TheEarthmaster/nightlight/hdw/nightlight/nightlight.xlsx

Reference | Quantity | Value | Digi-Key PN
C202 C201 C303 C402 C401 C502 C601 C701 C704 C802 C801 C901 C903 C904 C902 C905 | 16 | 0.1uF | 1276-1000-1-ND
C301 | 1 | 2.2uF | 1276-1085-1-ND
C302 | 1 | 22uF | 490-14661-1-ND
C304 | 1 | 47uF | 490-9961-1-ND
C503 C602 C604 C702 | 4 | 10nF | 311-1085-1-ND
C504 C501 | 2 | 4.7uF | 1276-2789-1-ND
C603 C703 | 2 | 1nF | 311-1080-1-ND
C705 | 1 | 100uF | 478-7997-1-ND
D505 | 1 | MBR0530 | MBR0530CT-ND
D509 D511 D507 D504 D502 D508 D510 D506 D503 D501 | 10 | warm white | 1214-1445-1-ND
D701 | 1 | 24V | SMAJ24CALFCT-ND
D901 D903 D905 | 3 | green | 160-1446-1-ND
D904 D902 | 2 | red | 160-1447-1-ND
H1001 H1002 H1003 H1004 | 4 | MountingHole
J201 | 1 | PICKIT3
J701 | 1 | +12V IN AUX | CP-202BH-ND
J801 | 1 | PIR Sensor | 1528-1991-ND
L301 | 1 | 4.7uH | 541-1222-1-ND
L501 | 1 | 3.3uH | 541-1269-1-ND
Q201 | 1 | 2N7002 | 2N7002NCT-ND
Q601 | 1 | BPW85A | BPW85A-ND
Q701 Q702 | 2 | IPC100N04S51R7ATMA1 | IPC100N04S51R7ATMA1CT-ND
R201 R203 R705 R706 | 4 | 10 | A130079CT-ND
R202 R204 R305 R303 R304 R301 R402 R502 R601 R707 R801 R802 R905 R902 R906 | 15 | 10k | RNCP0603FTD10K0CT-ND
R302 | 1 | 1.2k | RMCF0603FT1K20CT-ND
R401 R602 | 2 | 499 | P499HCT-ND
R501 | 1 | 5.1K | 311-5.10KHRCT-ND
R503 | 1 | 0.18 | RL12S.18FCT-ND
R504 | 1 | 15.8K | 311-15.8KHRCT-ND
R505 | 1 | 1.07k | RMCF0603FT1K07CT-ND
R701 | 1 | 6.04M | 541-6.04MHCT-ND
R702 | 1 | 86.6k | RMC50603FT86K6CT-ND
R703 | 1 | 243k | RMCF0603FT243KCT-ND
R704 | 1 | 100k | RMCF0603FT100KCT-ND
R708 | 1 | 5.1k | 749-16663-1-ND
R901 R904 R907 R903 R908 | 5 | 1k | RNCP0603FTD1K00CT-ND
SW201 | 1 | MRST
SW401 | 1 | Cap_Touch
U201 | 1 | PIC16F1518-ISO | PIC16F1518-I/SOCT-ND
U301 | 1 | LTC3624DD | LTC3624IDD-3.3#PBF
U401 | 1 | AT42QT1010-TSHR | AT42AT1010-TSHRCT-ND
U501 | 1 | LT1618DD | LT1618EDD#PBF-ND
U601 | 1 | OPA340NA | 296-26275-1-ND
U701 | 1 | LTC4365DDB | LTC4365IDDB#TRMPBFCT-ND
U801 | 1 | 74LVC1G17 | 296-11934-1-ND
U901 U903 U904 U902 U905 | 5 | 74LVC1G06_Power | 296-8484-1-ND
