TheEarthmaster/nightlight/(list of files, cad)

Other CAD files:
sfw/u201_firmware/nightlight_firmware.X/dist/default/production/nightlight_firmware.X.production.obj
