TheEarthmaster/nightlight/hdw/nightlight/nightlight.pdf

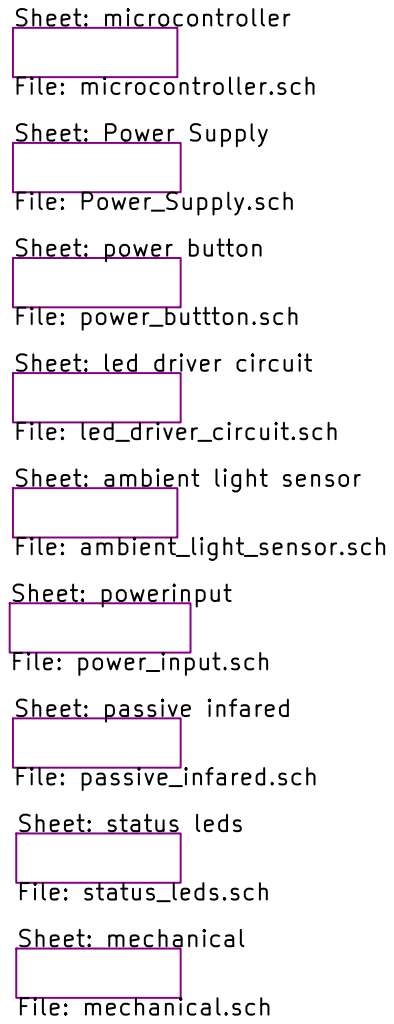
[picture p1: page 1]

Sheet: microcontroller File: microcontroller.sch Sheet: Power Supply

File: power_buttton.sch Sheet: led driver circuit File: led_driver_circuit.sch Sheet: ambient light sensor

File: passive_infared.sch Sheet: status leds File: status_leds.sch Sheet: mechanical File: mechanical.sch

File: nightlight.sch Sheet: /

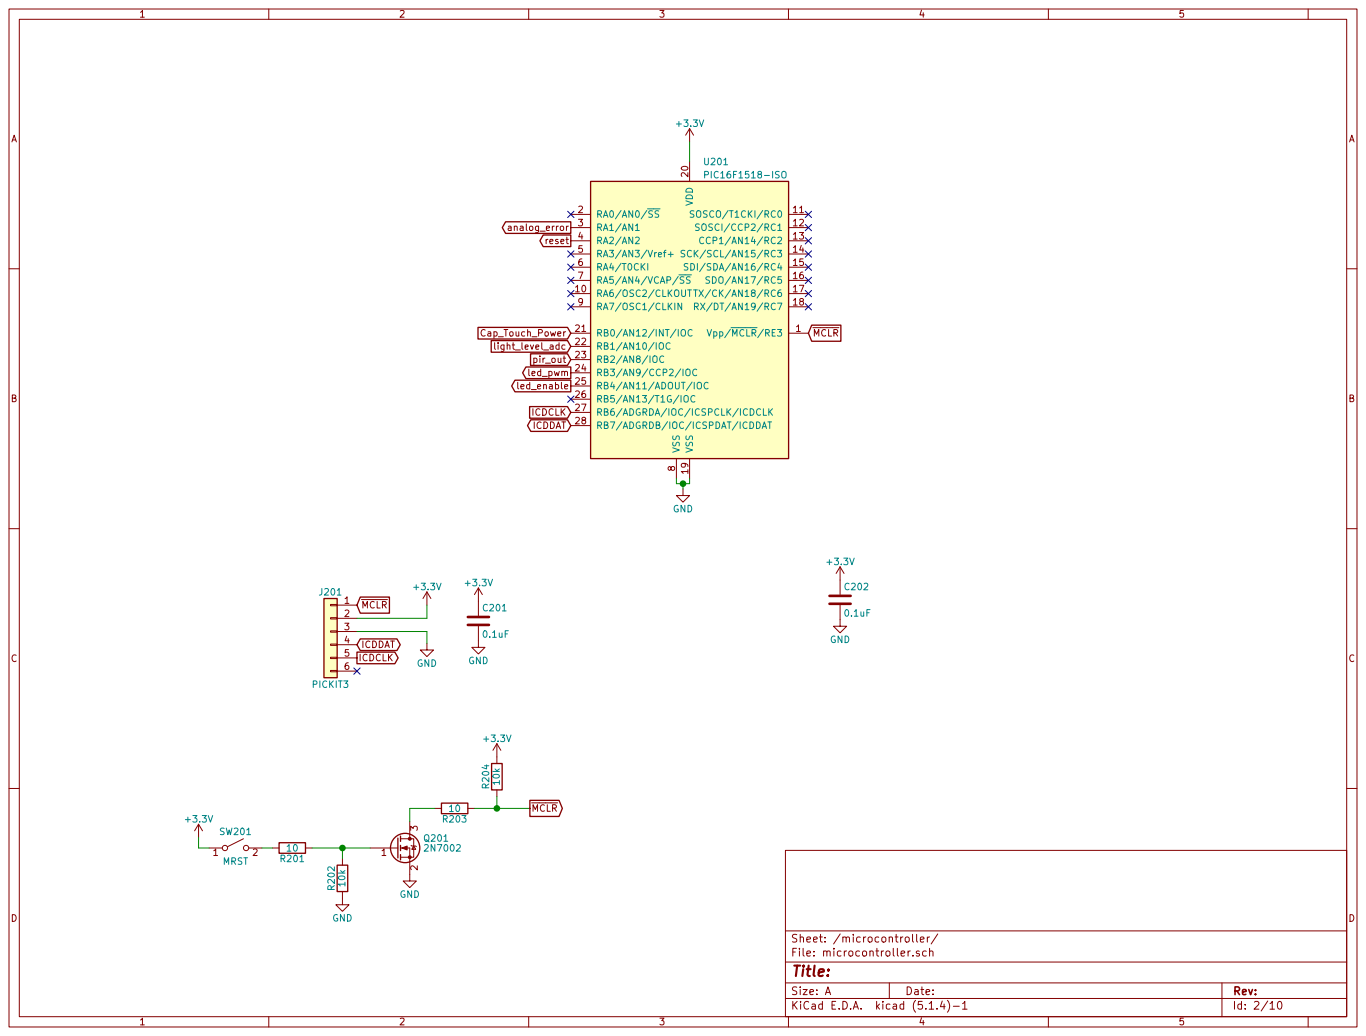
[picture p2: page 2]

Id: 2/10 Title: File: microcontroller.sch Sheet: /microcontroller/ 123456
ICDCLK MCLR

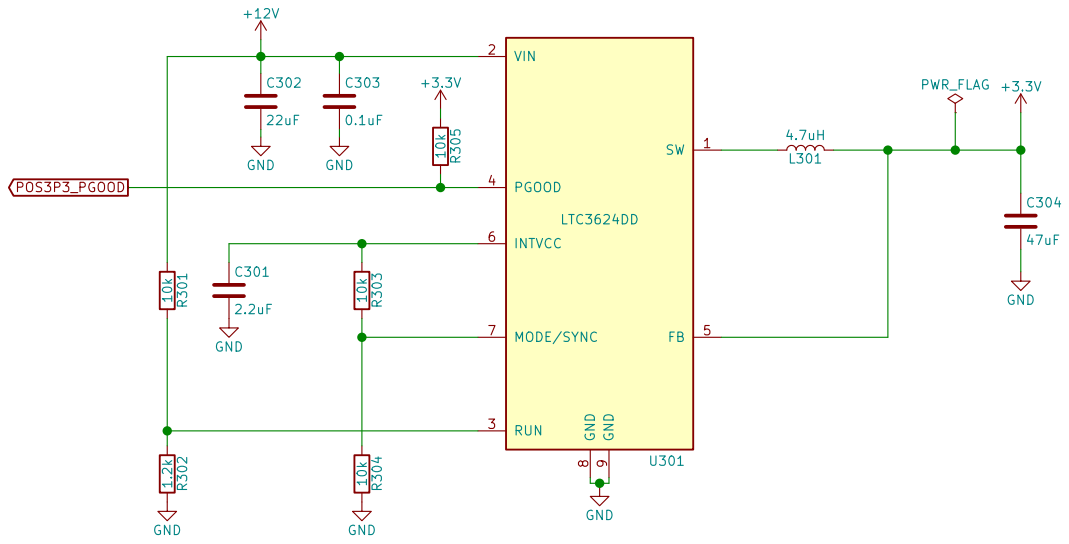
[picture p3: page 3]

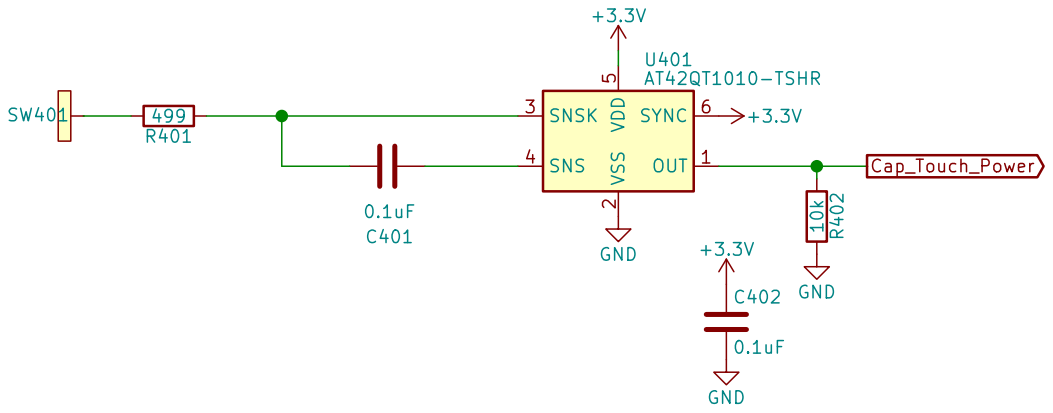
[picture p4: page 4]

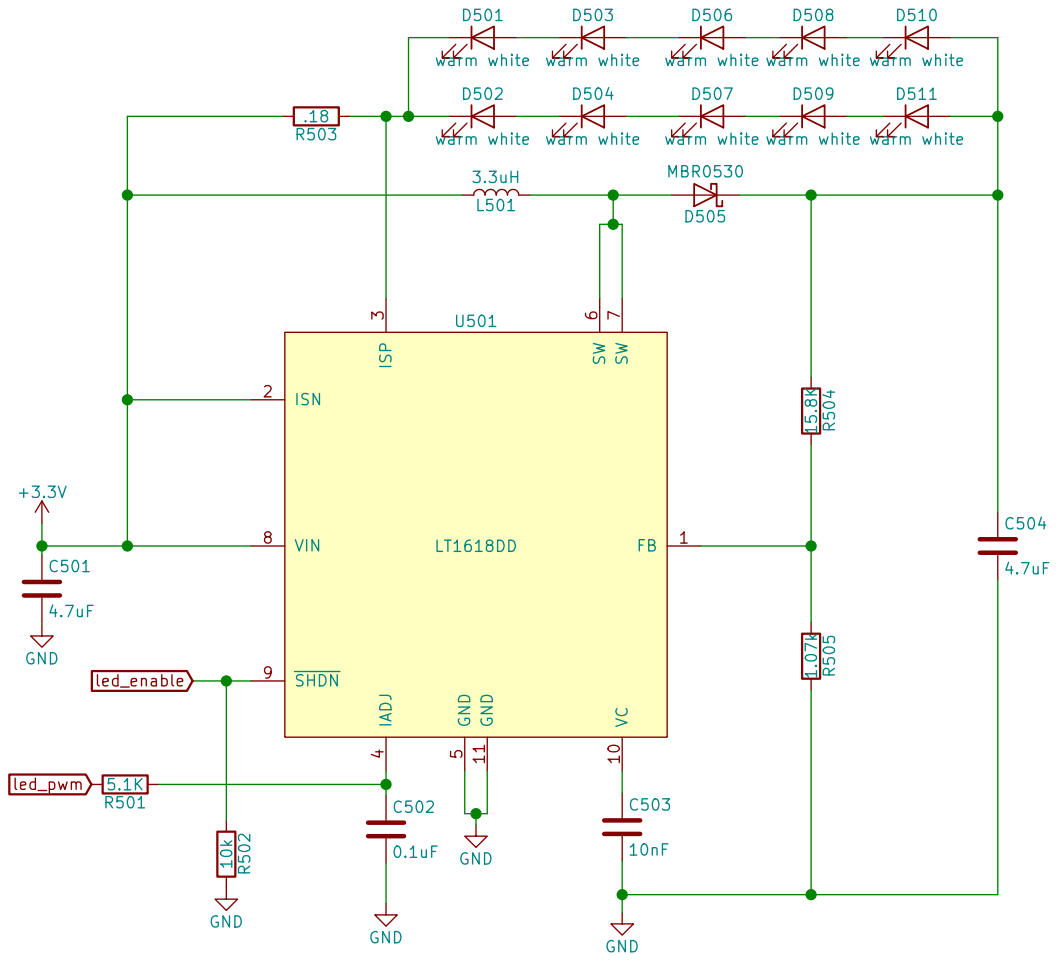
[picture p5: page 5]

File: led_driver_circuit.sch Sheet: /led driver circuit/

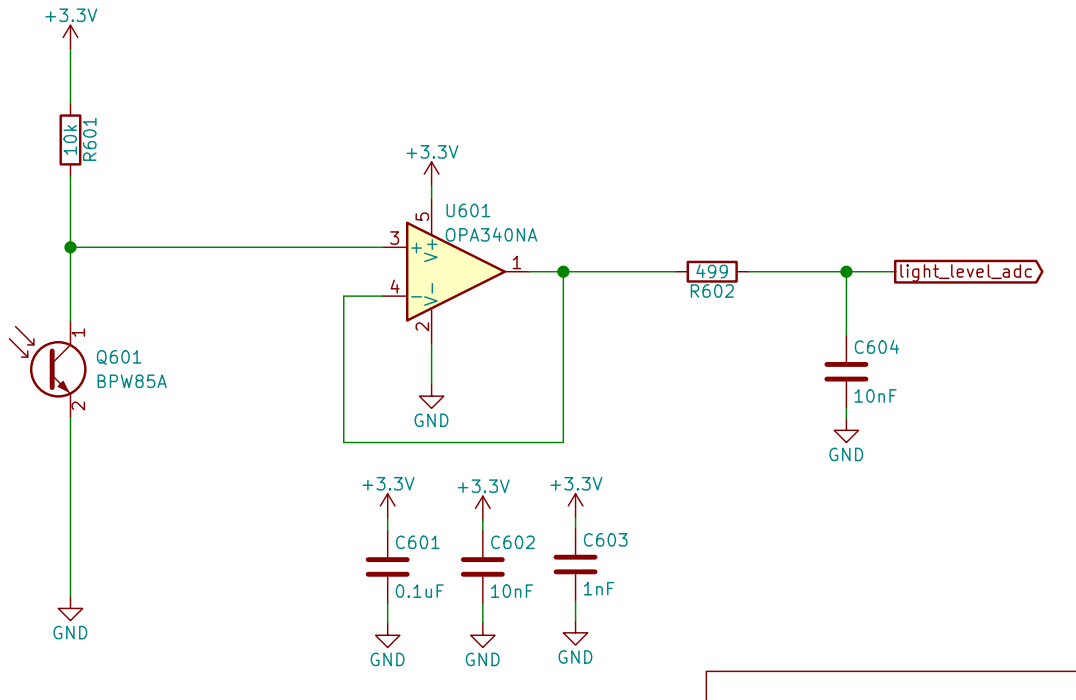
[picture p6: page 6]

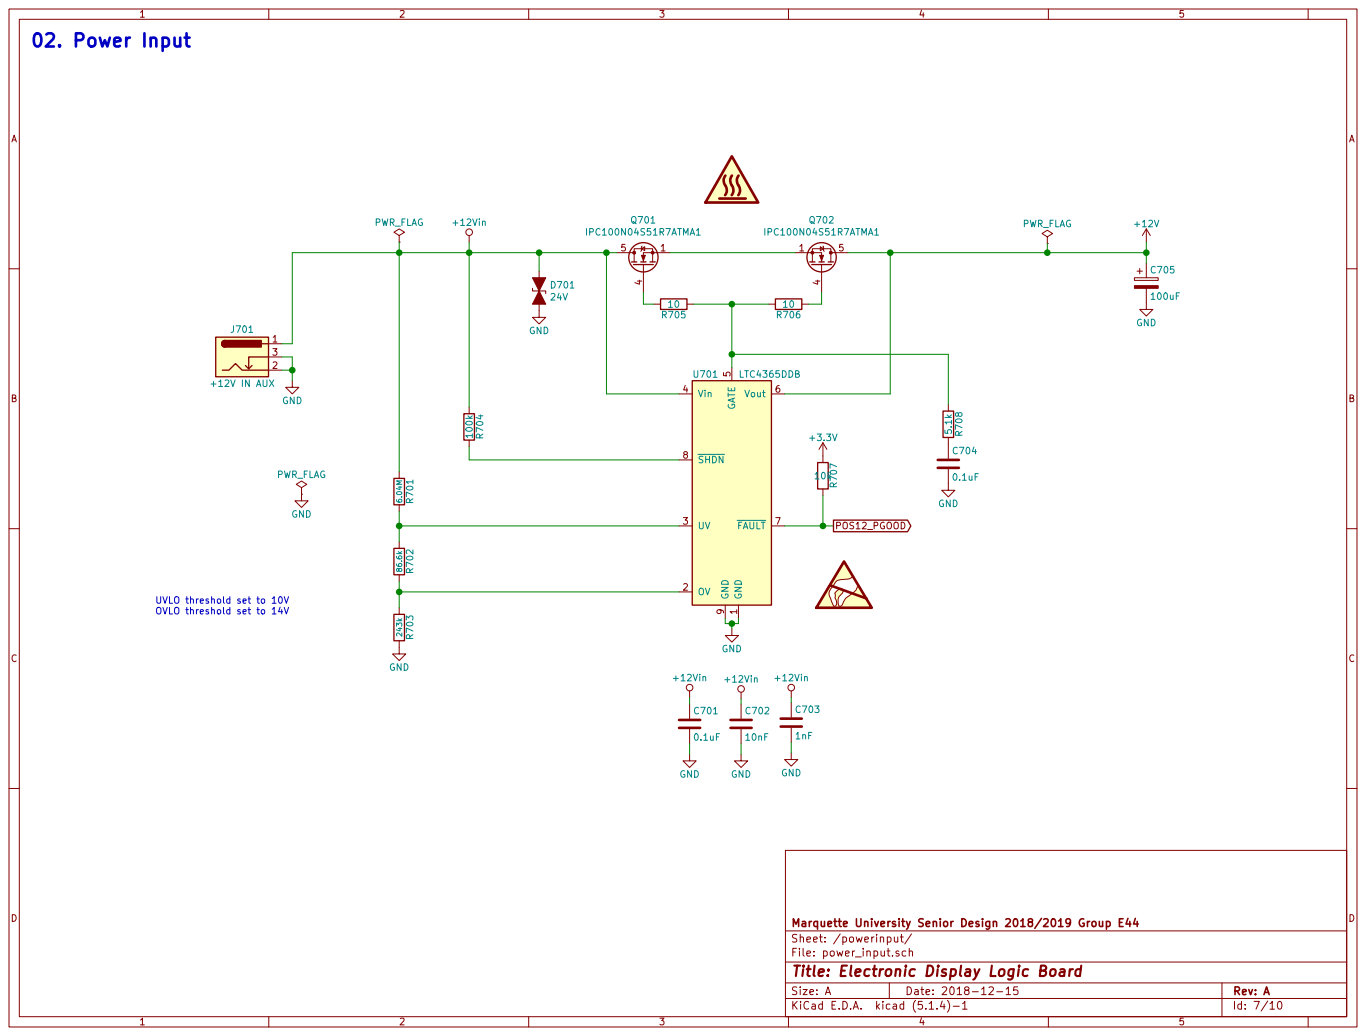
[picture p7: page 7]

POS12_PGOOD 02. Power InputUVLO threshold set to 10V OVLO threshold set to 14V

5 Vout 6 FAULT 7 SHDN 8 GND

1 OV 2 UV 3 Vin 4 GATE

Marquette University Senior Design 2018/2019 Group E44
Sheet: /powerinput/
File: power_input.sch
Id: 7/10 Title: Electronic Display Logic Board

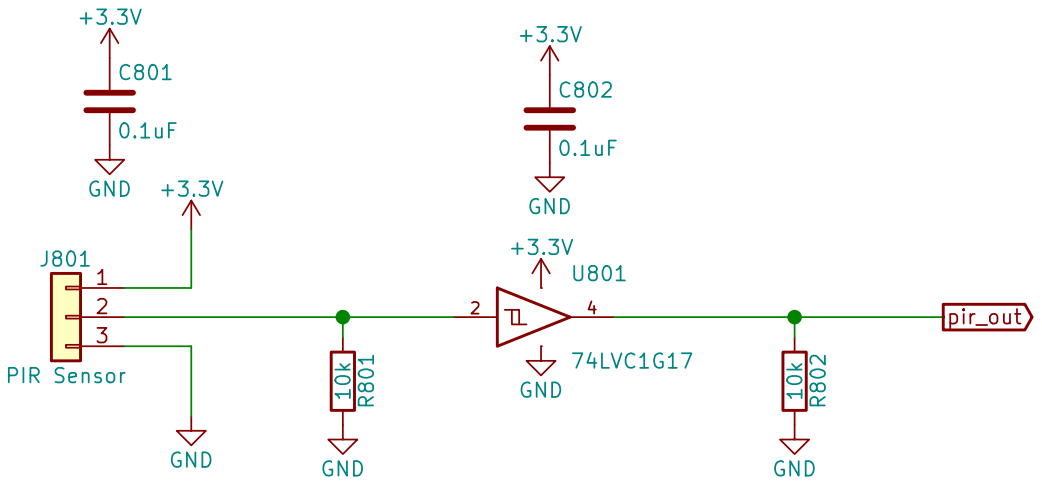
[picture p8: page 8]

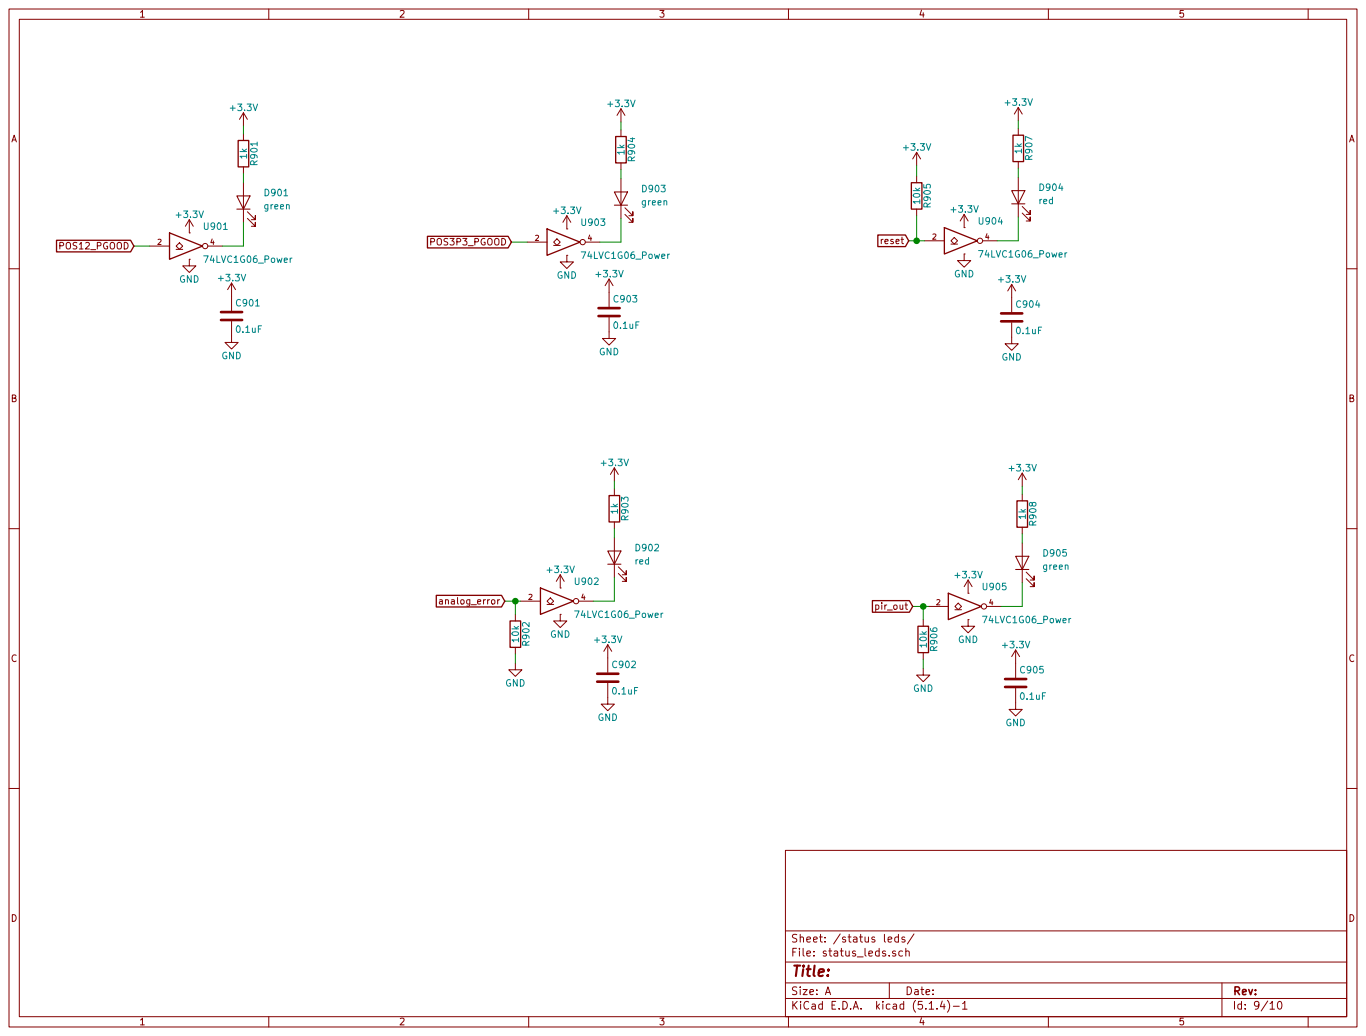
[picture p9: page 9]

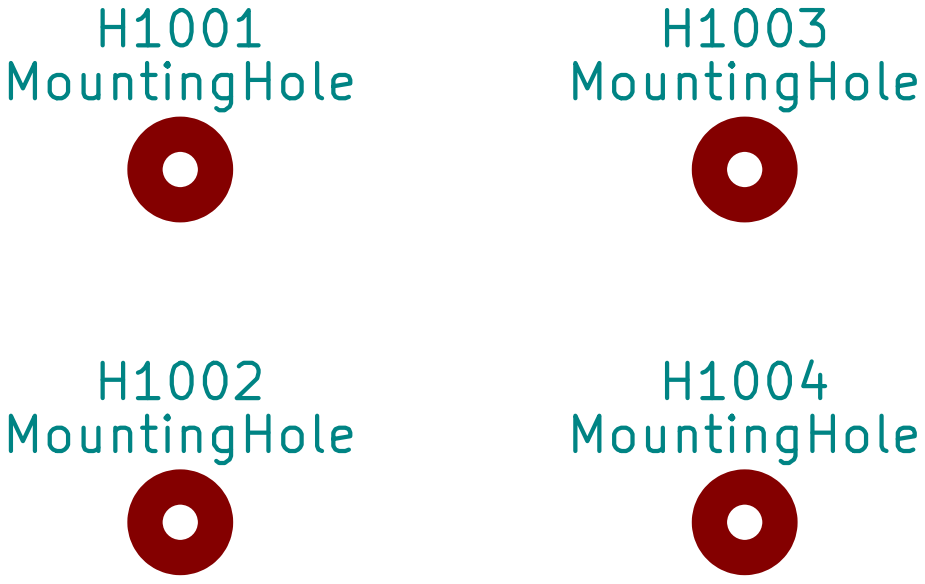
[picture p10: page 10]

Id: 10/10 Title: File: mechanical.sch Sheet: /mechanical/
