TheEarthmaster/nightlight/hdw/nightlight/nightlight.kicad_pcb

## KiCad design hdw/nightlight/nightlight.kicad_pcb (2019-10-02)

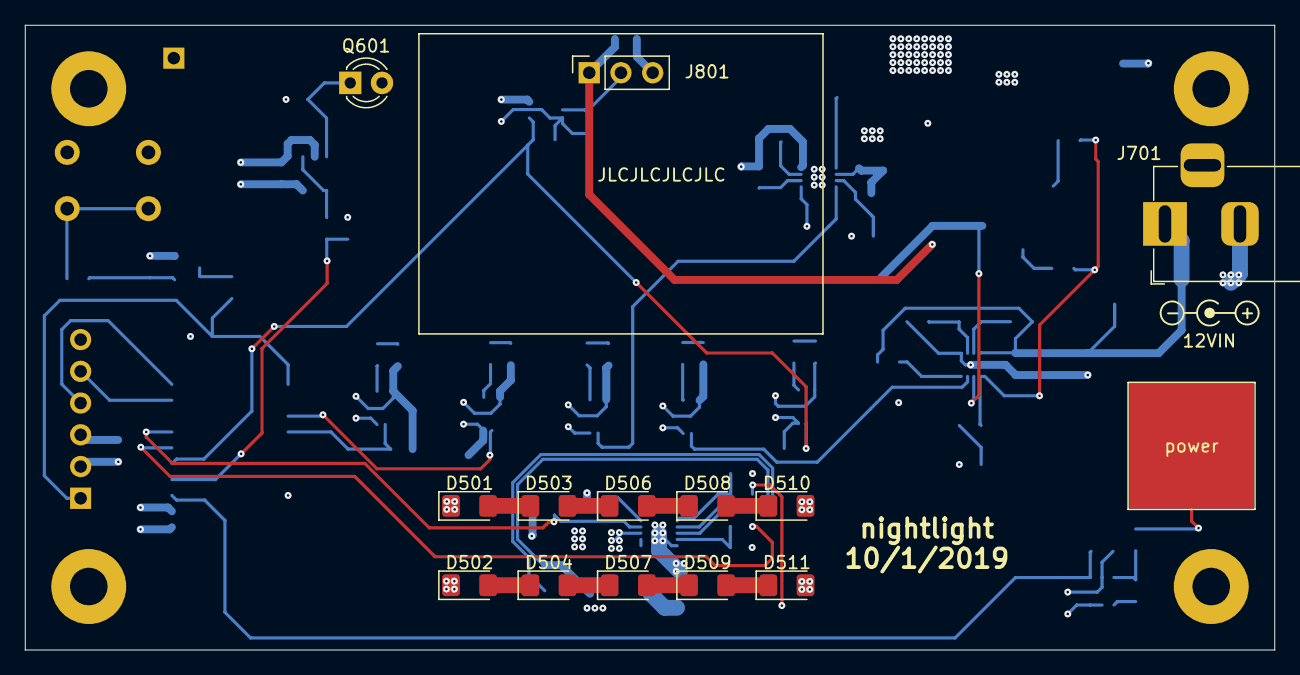
[picture p11: board nightlight.kicad_pcb from above]

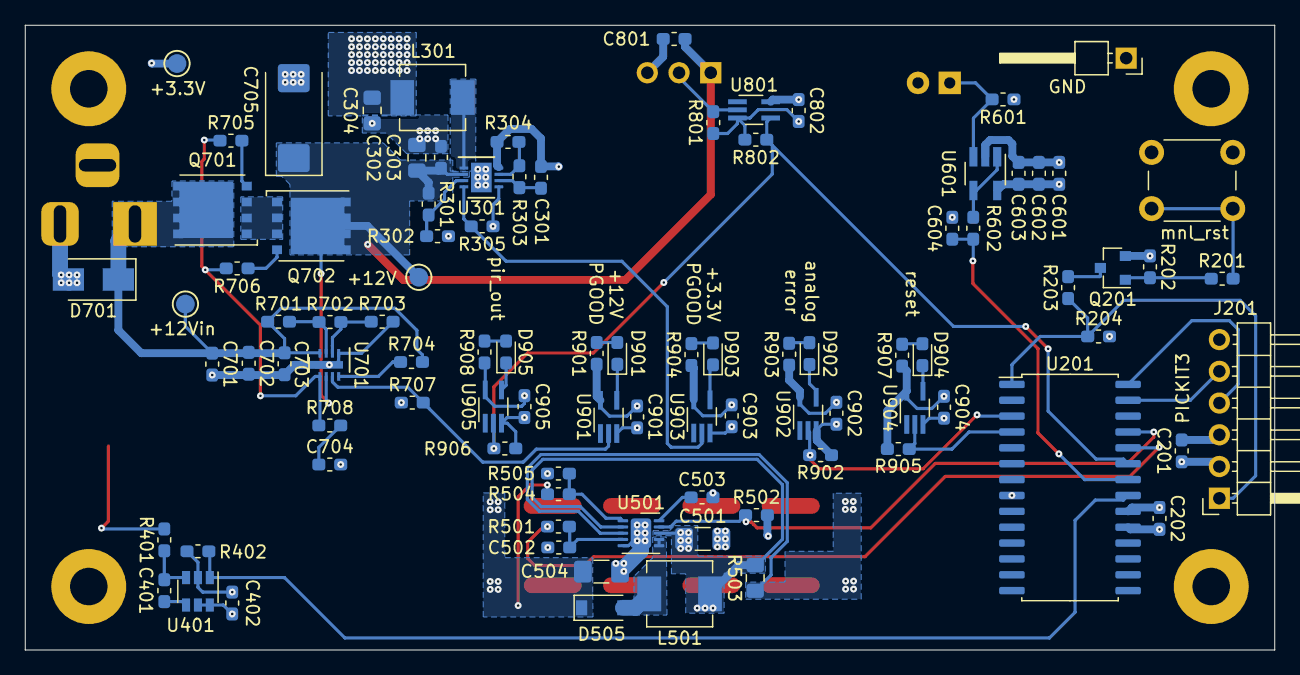
[picture p12: board nightlight.kicad_pcb from below]

Board: 4 copper layers, 100.0 x 50.0 mm, 112 parts (94 on the bottom side), 61 nets.

Parts:
C201, C202, C303, C401, C402, C502, C601, C701, C704, C801, C802, C901, C902, C903, C904, C905: 0.1uF; C_0603_1608Metric_Pad1.05x0.95mm_HandSolder
C301: 2.2uF; C_0603_1608Metric_Pad1.05x0.95mm_HandSolder
C302: 22uF; C_0805_2012Metric_Pad1.15x1.40mm_HandSolder
C304: 47uF; C_0805_2012Metric_Pad1.15x1.40mm_HandSolder
C501, C504: 4.7uF; C_1206_3216Metric_Pad1.42x1.75mm_HandSolder
C503, C602, C604, C702: 10nF; C_0603_1608Metric_Pad1.05x0.95mm_HandSolder
C603, C703: 1nF; C_0603_1608Metric_Pad1.05x0.95mm_HandSolder
C705: 100uF; CP_EIA-7343-31_Kemet-D_Pad2.25x2.55mm_HandSolder
D501, D502, D503, D504, D506, D507, D508, D509, D510, D511: warm white; LED_1206_3216Metric_Pad1.42x1.75mm_HandSolder
D505: MBR0530; D_SOD-123
D701: 24V; D_SMA
D901, D903, D905: green; LED_0603_1608Metric_Pad1.05x0.95mm_HandSolder
D902, D904: red; LED_0603_1608Metric_Pad1.05x0.95mm_HandSolder
H1001, H1002, H1003, H1004: MountingHole; MountingHole_3mm_Pad
J201: PICKIT3; PICKIT3_Header
J701: +12V IN AUX; BarrelJack_Horizontal
J801: PIR Sensor; pirsensor
L301: 4.7uH; L_Vishay_IHLP-2020
L501: 3.3uH; L_Vishay_IHLP-2020
Q201: 2N7002; SOT-23
Q601: BPW85A; LED_D3.0mm_Clear
Q701, Q702: IPC100N04S51R7ATMA1; TDSON-8-1
R201, R203, R705, R706: 10; R_0603_1608Metric_Pad1.05x0.95mm_HandSolder
R202, R204, R301, R303, R304, R305, R402, R502, R601, R707, R801, R802, R902, R905, R906: 10k; R_0603_1608Metric_Pad1.05x0.95mm_HandSolder
R302: 1.2k; R_0603_1608Metric_Pad1.05x0.95mm_HandSolder
R401, R602: 499; R_0603_1608Metric_Pad1.05x0.95mm_HandSolder
R501: 5.1K; R_0603_1608Metric_Pad1.05x0.95mm_HandSolder
R503: .18; R_0805_2012Metric_Pad1.15x1.40mm_HandSolder
R504: 15.8K; R_0603_1608Metric_Pad1.05x0.95mm_HandSolder
R505: 1.07k; R_0603_1608Metric_Pad1.05x0.95mm_HandSolder
R701: 6.04M; R_0603_1608Metric_Pad1.05x0.95mm_HandSolder
R702: 86.6k; R_0603_1608Metric_Pad1.05x0.95mm_HandSolder
R703: 243k; R_0603_1608Metric_Pad1.05x0.95mm_HandSolder
R704: 100k; R_0603_1608Metric_Pad1.05x0.95mm_HandSolder
R708: 5.1k; R_0603_1608Metric_Pad1.05x0.95mm_HandSolder
R901, R903, R904, R907, R908: 1k; R_0603_1608Metric_Pad1.05x0.95mm_HandSolder
SW201: MRST; SW_PUSH_6mm
SW401: Cap_Touch; Capacitive_Touch_Pad_Wide
TP301, TP702, TP703: TP; Test_Point
TP701: TP; PinHeader_1x01_P2.54mm_Horizontal
U201: PIC16F1518-ISO; SOIC-28W_7.5x17.9mm_P1.27mm
U301: LTC3624DD; DFN-8-1EP_3x3mm_P0.5mm_EP1.66x2.38mm
U401: AT42QT1010-TSHR; SOT-23-6
U501: LT1618DD; DFN-10-1EP_3x3mm_P0.5mm_EP1.65x2.38mm
U601: OPA340NA; SOT-23-5_HandSoldering
U701: LTC4365DDB; DFN-8-1EP_2x3mm_P0.5mm_EP0.61x2.2mm
U801: 74LVC1G17; SOT-353_SC-70-5_Handsoldering
U901, U902, U903, U904, U905: 74LVC1G06_Power; SOT-353_SC-70-5_Handsoldering

Connections:
+3V3: C201.1, C202.1, C304.1, C402.1, C501.1, C601.1, C602.1, C603.1, C802.1, C901.1, C902.1, C903.1, C904.1, C905.1, J201.2, L301.2, L501.1, R204.2, R305.1, R503.2, R601.1, R707.1, R901.1, R903.1, R904.1, R905.1, R907.1, R908.1, SW201.1, TP301.1, U201.20, U301.5, U401.5, U401.6, U501.2, U501.8, U601.5, U801.5, U901.5, U902.5, U903.5, U904.5, U905.5
+12V: C302.1, C303.1, C705.1, C801.1, J801.1, Q702.5, R301.1, TP703.1, U301.2, U701.6
+12Vin: C701.1, C702.1, C703.1, D701.1, J701.1, Q701.5, R701.1, R704.1, TP702.1, U701.4
Cap_Touch_Power: R402.1, U201.21, U401.1
GND: C201.2, C202.2, C301.2, C302.2, C303.2, C304.2, C402.2, C501.2, C502.2, C503.2, C504.2, C601.2, C602.2, C603.2, C604.2, C701.2, C702.2, C703.2, C704.2, C705.2, C801.2, C802.2, C901.2, C902.2, C903.2, C904.2, C905.2, D701.2, J201.3, J701.2, J701.3, J801.3, Q201.2, Q601.2, R202.1, R302.2, R304.2, R402.2, R502.2, R505.2, R703.2, R801.2, R802.2, R902.2, R906.2, TP701.1, U201.8, U201.19, U301.8, U301.9, U401.2, U501.5, U501.11, U601.2, U701.1, U701.9, U801.3, U901.3, U902.3, U903.3, U904.3, U905.3
ICDCLK: J201.5, U201.27
ICDDAT: J201.4, U201.28
unnamed: C301.1, R303.1, U301.6
unnamed: C401.1, R401.1, U401.3
unnamed: C401.2, U401.4
unnamed: C502.1, R501.1, U501.4
unnamed: C503.1, U501.10
unnamed: C504.1, D505.1, D510.2, D511.2, R504.1
unnamed: C704.1, R708.2
unnamed: D501.1, D502.1, R503.1, U501.3
unnamed: D501.2, D503.1
unnamed: D502.2, D504.1
unnamed: D503.2, D506.1
unnamed: D504.2, D507.1
unnamed: D505.2, L501.2, U501.6, U501.7
unnamed: D506.2, D508.1
unnamed: D507.2, D509.1
unnamed: D508.2, D510.1
unnamed: D509.2, D511.1
unnamed: D901.1, U901.4
unnamed: D901.2, R901.2
unnamed: D902.1, U902.4
unnamed: D902.2, R903.2
unnamed: D903.1, U903.4
unnamed: D903.2, R904.2
unnamed: D904.1, U904.4
unnamed: D904.2, R907.2
unnamed: D905.1, U905.4
unnamed: D905.2, R908.2
unnamed: J801.2, R801.1, U801.2
unnamed: L301.1, U301.1
unnamed: Q201.1, R201.1, R202.2
unnamed: Q201.3, R203.2
unnamed: Q601.1, R601.2, U601.3
unnamed: Q701.1, Q701.2, Q701.3, Q702.1, Q702.2, Q702.3
unnamed: Q701.4, R705.2
unnamed: Q702.4, R706.1
unnamed: R201.2, SW201.2
unnamed: R301.2, R302.1, U301.3
unnamed: R303.2, R304.1, U301.7
unnamed: R401.2, SW401.1
unnamed: R504.2, R505.1, U501.1
unnamed: R602.2, U601.1, U601.4
unnamed: R701.2, R702.1, U701.3
unnamed: R702.2, R703.1, U701.2
unnamed: R704.2, U701.8
unnamed: R705.1, R706.2, R708.1, U701.5
POS3P3_PGOOD: R305.2, U301.4, U903.2
POS12_PGOOD: R707.2, U701.7, U901.2
analog_error: R902.1, U201.3, U902.2
led_enable: R502.1, U201.25, U501.9
led_pwm: R501.2, U201.24
light_level_adc: C604.1, R602.1, U201.22
pir_out: R802.1, R906.1, U201.23, U801.4, U905.2
reset: R905.2, U201.4, U904.2
~MCLR: J201.1, R203.1, R204.1, U201.1
