TheEarthmaster/nightlight/(commit log)

2019-08-28 Began project, drew a few schematic sheets
    [Power_Supply.sch, microcontroller.sch, nightlight.kicad_pcb, nightlight.sch, power_buttton.sch]
2019-09-05 Added ambient light sensor, LED driver
    [Power_Supply.sch, ambient_light_sensor.sch, led_driver_circuit.sch, microcontroller.sch, nightlight.sch, power_buttton.sch]
2019-09-18 finished schematic
    [Power_Supply.sch, led_driver_circuit.sch, mechanical.sch, microcontroller.sch, nightlight.sch, passive_infared.sch, power_buttton.sch, power_input.sch]
2019-09-24 added Digi-Key p/n
    [Power_Supply.sch, ambient_light_sensor.sch, led_driver_circuit.sch, microcontroller.sch, nightlight.xlsx, passive_infared.sch, power_buttton.sch, power_input.sch]
2019-09-25 Assigned footprints
    [Power_Supply.sch, ambient_light_sensor.sch, led_driver_circuit.sch, mechanical.sch, microcontroller.sch, nightlight.kicad_pcb, passive_infared.sch, power_buttton.sch]
2019-09-25 Started arranging components on PCB
    [nightlight.kicad_pcb]
2019-09-25 Arranged footprints for power button, buck converter
    [nightlight.kicad_pcb]
2019-09-29 Finished arranging components on PCB
    [nightlight.kicad_pcb]
2019-09-29 Placed components on virtual board
    [nightlight.kicad_pcb]
2019-09-29 Started routing, minor schematic changes
    [Power_Supply.sch, nightlight.kicad_pcb, passive_infared.sch, power_input.sch]
2019-10-02 finished PCD
    [nightlight.kicad_pcb]
2019-11-08 Got PWM fading working
2019-11-15 Added IOC stuff
    [nightlight-B_Cu.gbr, nightlight-B_Mask.gbr, nightlight-B_SilkS.gbr, nightlight-Edge_Cuts.gbr, nightlight-F_Cu.gbr, nightlight-F_Mask.gbr, nightlight-F_SilkS.gbr, nightlight-NPTH.drl]
2019-11-15 PIR sensor working
    [nightlight_firmware.X.production.obj]
2019-11-17 finished fmw project
    [nightlight_firmware.X.production.obj]
